EmbeddedSystemClass/LimeNET-Micro/hardware/2v1/LimeNet-Micro_2v1-SDR1/02.pdf

# Power diagram

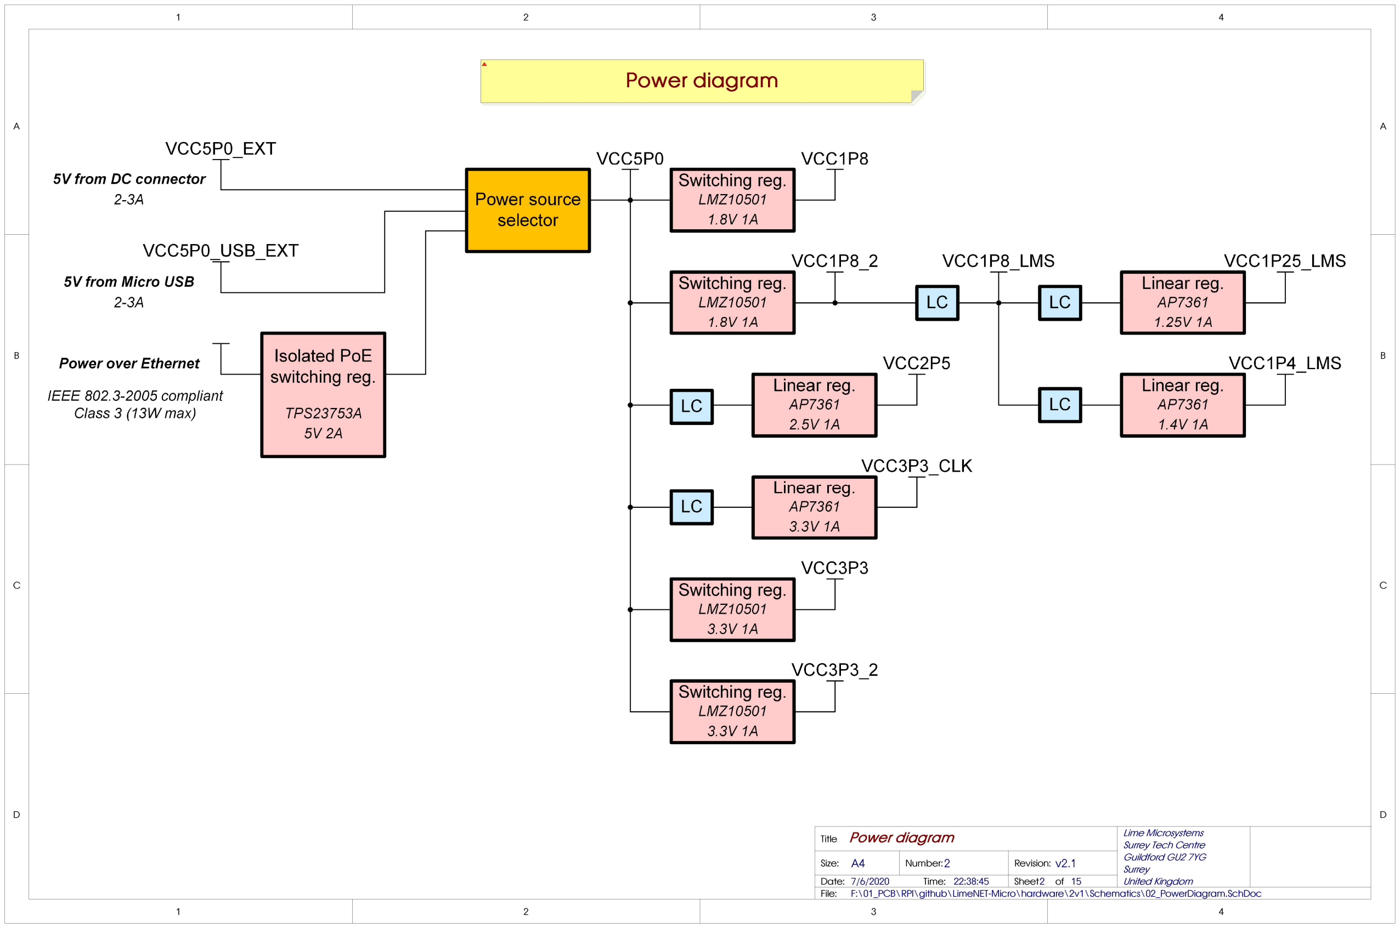
[picture p1: page 1]

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
Lime Microsystems
Surrey Tech Centre
Guildford GU2 7YG
Surrey

### 15 United Kingdom

## Power diagram

### 2 v2.1

7/6/2020 | 22:38:45
F:\01_PCB\RPI\github\LimeNET-Micro\hardware\2v1\Schematics\02_PowerDiagram.SchDoc

Title

Size: | Number:
Date:
File:

Revision:
Time: | Sheet | of

A4
