EmbeddedSystemClass/LimeNET-Micro/hardware/2v1/Project Outputs for LimeNet-Micro_2v1-SDR/BOM/LimeNET-Micro_2v1_SDR_BOMr2.xls

Item # | Comment | Quantity | Designator | Footprint | Manufacturer | Manufacturer Part Number 1 | Supplier 1 | Supplier Part Number 1 | Part Description | Assembly Info
1 | TCMT1107CT | 1 | AT1 | TCMT1107CT_optoisolator | Vishay Semiconductors | TCMT1107 | Digi-Key | TCMT1107CT-ND | Optoisolator Transistor Output 5000Vrms 1 Channel 4-SMD
2 | HD01-T | 2 | BR1, BR2 | HD01-T _RECTIFIER_BRIDGE_v1 | Diodes | HD01-T | Digi-Key | HD01DITR-ND | Bridge Rectifier Single Phase Standard 100V Surface Mount 4-MiniDIP
3 | 10pF, 25V | 8 | C1, C20, C21, C30, C31, C167, C168, C283 | CAP0402 | AVX | 04023A100JAT2A | Farnell | 2332478RL | 10pF ±5% 25V C0G, NP0 Ceramic Capacitor -55°C ~ 125°C Surface Mount, MLCC 0402 (1005 Metric) 0.039" L x 0.020" W (1.00mm x 0.50mm)
4 | 100nF, 16V | 73 | C2, C4, C6, C14, C17, C98, C135, C137, C138, C139, C141, C142, C143, C144, C145, C146, C147, C148, C149, C151, C153, C155, C156, C157, C158, C159, C160, C161, C162, C163, C164, C165, C166, C169, C177, C178, C179, C181, C202, C212, C214, C215, C217, C218, C219, C220, C221, C222, C223, C226, C227, C230, C233, C234, C235, C236, C237, C240, C244, C249, C252, C255, C258, C260, C261, C267, C272, C273, C282, C284, C330, MN15, MN20 | CAP0402 | Murata Electronics | GRM155R71C104KA88D | Mouser | 81-GRM155R71C104KA88 | CAP CER 0.1UF 16V X7R 0402 | NF(C135 C169 C179 C218 C220 C221 C222 C223 C255 C258 C272 C284)
5 | 100pF, 50V | 47 | C3, C5, C7, C8, C9, C10, C11, C12, C13, C15, C16, C18, C19, C22, C23, C24, C25, C26, C27, C28, C29, C32, C33, C34, C35, C36, C37, C38, C134, C136, C140, C239, C245, C246, C250, C251, C253, C254, C262, C263, C264, C265, C268, C269, C270, C271, C300 | CAP0402 | Yageo | CC0402JRNPO9BN101 | Digi-Key | 311-1024-1-ND | 100pF ±5% 50V C0G, NP0 Ceramic Capacitor -55°C ~ 125°C Surface Mount, MLCC 0402 (1005 Metric) 0.039" L x 0.020" W (1.00mm x 0.50mm) | NF(C7 C8 C18 C19 C24 C32)
6 | 1uF, 6.3V | 60 | C39, C42, C44, C46, C48, C50, C51, C52, C53, C54, C55, C56, C57, C58, C59, C60, C61, C62, C63, C65, C66, C67, C68, C69, C70, C72, C74, C76, C77, C78, C79, C80, C81, C82, C83, C84, C85, C86, C87, C88, C89, C90, C91, C92, C93, C94, C95, C96, C97, C100, C107, C114, C120, C124, C184, C186, C188, C190, C193, C201 | CAP0201 | TDK Corporation | JMK063ABJ105MP-F | Digi-Key | 587-5864-2-ND | 1µF ±20% 6.3V X5R Ceramic Capacitor -55°C ~ 85°C Surface Mount, MLCC 0201 (0603 Metric) 0.024" L x 0.012" W (0.60mm x 0.30mm)
7 | 10uF, 6.3V | 12 | C40, C99, C106, C113, C119, C123, C133, C183, C192, C200, C213, C325 | CAP0603 | Yageo | CC0603MRX5R5BB106 | Digi-Key | 311-1448-2-ND | 10µF ±20% 6.3V X5R Ceramic Capacitor -55°C ~ 85°C Surface Mount, MLCC 0603 (1608 Metric) 0.063" L x 0.031" W (1.60mm x 0.80mm)
8 | 1nF, 10% | 9 | C41, C43, C45, C47, C49, C64, C71, C73, C75 | CAP0201 | TDK Corporation | C0603X7R1E102K030BA | Digi-Key | 445-7275-1-ND | 1000pF ±10% 25V X7R Ceramic Capacitor -55°C ~ 125°C Surface Mount, MLCC 0201 (0603 Metric) 0.024" L x 0.012" W (0.60mm x 0.30mm)
9 | 100nF, 6.3V | 30 | C101, C102, C103, C104, C105, C108, C109, C110, C111, C112, C115, C116, C117, C118, C121, C122, C125, C126, C127, C128, C129, C130, C131, C185, C187, C189, C191, C194, C196, C198 | CAP0201 | Murata | GRT033C81A104KE01D | Digi-Key | 490-12232-1-ND | 0.10µF ±10% 6.3V X6S Ceramic Capacitor -55°C ~ 105°C Surface Mount, MLCC 0201 (0603 Metric) 0.024" L x 0.012" W (0.60mm x 0.30mm)
10 | 1uF, 10V | 17 | C132, C154, C204, C205, C206, C207, C229, C243, C247, C248, C256, C257, C266, C281, C292, C305, C329 | CAP0402 | Yageo | CC0402MRX5R6BB105 | Digi-Key | 311-1732-1-ND | 1µF 10V Ceramic Capacitor X5R 0402 (1005 Metric) 0.039" L x 0.020" W (1.00mm x 0.50mm) | NF(C256 C257)
11 | 4.7uF, 6.3V | 11 | C150, C203, C211, C312, C313, C314, C315, C318, C319, C320, C321 | CAP0402 | Murata Electronics North America | GRM155R60J475ME87D | Digi-Key | 490-5408-1-ND | 4.7µF ±20% 6.3V X5R Ceramic Capacitor -55°C ~ 85°C Surface Mount, MLCC 0402 (1005 Metric) 0.039" L x 0.020" W (1.00mm x 0.50mm) | NF(C312 C313)
12 | 22nF, 50V | 1 | C152 | CAP0402 | Kemet | C0402C223K5RACTU | Digi-Key | 399-7780-1-ND | 0.022µF ±10% 50V Ceramic Capacitor X7R 0402 (1005 Metric)
13 | 13pF, 5% | 4 | C170, C171, C172, C173 | CAP0402 | Murata Electronics North America | GRM1555C1H130JA01D | Digi-Key | 490-5925-2-ND | 13pF ±5% 50V C0G, NP0 Ceramic Capacitor -55°C ~ 125°C Surface Mount, MLCC 0402 (1005 Metric) 0.039" L x 0.020" W (1.00mm x 0.50mm)
14 | 47uF, 10V | 6 | C174, C208, C209, C210, C225, C228 | CAP1206 | TDK Corporation | C3216X6S1A476M160AC | Digi-Key | 445-6010-1-ND | 47µF ±20% 10V Ceramic Capacitor X6S 1206 (3216 Metric)
15 | 22uF, 10V | 13 | C175, C176, C224, C231, C232, C308, C309, C310, C311, C322, C323, C324, C326 | CAP0603 | TDK Corporation | C1608X5R1A226M080AC | Mouser | 810-C1608X5R1A226M | 22µF ±20% 10V X5R Ceramic Capacitor -55°C ~ 85°C Surface Mount, MLCC 0603 (1608 Metric) 0.063" L x 0.031" W (1.60mm x 0.80mm) | NF(C224)
16 | 10pF, 5% | 2 | C180, C182 | CAP0402 | AVX | 04023A100JAT2A | Farnell | 2332478RL | 10pF ±5% 25V C0G, NP0 Ceramic Capacitor -55°C ~ 125°C Surface Mount, MLCC 0402 (1005 Metric) 0.039" L x 0.020" W (1.00mm x 0.50mm)
17 | 10nF, 50V | 3 | C195, C197, C199 | CAP0402 | Murata Electronics North America | GRM155R71H103KA88D | Digi-Key | 490-4516-2-ND | 10000pF ±10% 50V Ceramic Capacitor X7R 0402 (1005 Metric)
18 | 4.7nF, 50V | 1 | C216 | CAP0402 | Murata Electronics North America | GCM155R71H472KA37D | Digi-Key | 490-4915-1-ND | 4700pF ±10% 50V Ceramic Capacitor X7R 0402 (1005 Metric)
19 | 10uF, 16V | 1 | C238 | CAP0603 | Yageo | GRM188R61C106MA73D | Digi-Key | 490-7201-2-ND | 10µF ±20% 16V Ceramic Capacitor X5R 0603 (1608 Metric)
20 | 47pF, 50V | 2 | C241, C242 | CAP0402 | TDK Corporation | C1005C0G1H470F050BA | Digi-Key | 445-5361-1-ND | 47pF ±1% 50V C0G, NP0 Ceramic Capacitor -55°C ~ 125°C Surface Mount, MLCC 0402 (1005 Metric) 0.039" L x 0.020" W (1.00mm x 0.50mm) | NF(C241 C242)
21 | 18nF, 16V | 1 | C259 | CAP0402 | Yageo | CC0402KRX7R7BB183 | Digi-Key | 311-1706-1-ND | 0.018µF ±10% 16V Ceramic Capacitor X7R 0402 (1005 Metric) | NF(C259)
22 | 1nF, 10% | 2 | C274, C275 | CAP0402 | Murata Electronics | GCM155R71H102KA37D | Mouser | 81-GCM155R71H102KA7D | 1000pF ±10% 50V X7R Ceramic Capacitor -55°C ~ 125°C Surface Mount, MLCC 0402 (1005 Metric) 0.039" L x 0.020" W (1.00mm x 0.50mm)
23 | 1nF, 50V | 1 | C276 | CAP0402 | Murata Electronics North America | GCM155R71H102KA37D | Digi-Key | 490-4761-1-ND | 1000pF ±10% 50V Ceramic Capacitor X7R 0402 (1005 Metric)
24 | 22pF, 5% | 3 | C277, C278, C279 | CAP0402 | Yageo | CC0402JRNPO9BN220 | Digi-Key | 311-1018-2-ND | 22pF ±5% 50V C0G, NP0 Ceramic Capacitor -55°C ~ 125°C Surface Mount, MLCC 0402 (1005 Metric) 0.039" L x 0.020" W (1.00mm x 0.50mm)
25 | 220pF, 10% | 1 | C280 | CAP0402 | Yageo | CC0402KRX7R9BB221 | Digi-Key | 311-1035-2-ND | 220pF ±10% 50V X7R Ceramic Capacitor -55°C ~ 125°C Surface Mount, MLCC 0402 (1005 Metric) 0.039" L x 0.020" W (1.00mm x 0.50mm)
26 | 100nF, 100V | 4 | C285, C293, C298, C299 | CAP0603 | Murata Electronics North America | GRM188R72A104KA35D | Digi-Key | 490-3285-1-ND | 0.1µF ±10% 100V Ceramic Capacitor X7R 0603 (1608 Metric)
27 | 10uF, 100V | 2 | C286, C287 | CAP_POL_SIZE_E | Panasonic | EEE2AA100UP | Digi-Key | PCE3966CT-ND | 10µF 100V Aluminum Electrolytic Capacitors Radial, Can - SMD 2000 Hrs @ 85°C
28 | 2.2uF, 100V | 2 | C288, C289 | CAP1206 | TDK Corporation | C3216X7S2A225K160AE | Digi-Key | 445-8900-1-ND | 2.2µF ±10% 100V Ceramic Capacitor X7S 1206 (3216 Metric)
29 | 1nF, 100V | 3 | C290, C291, C297 | CAP0603 | KEMET | C0603C102K1RACTU | Digi-Key | 399-7831-2-ND | 1000pF ±10% 100V Ceramic Capacitor X7R 0603 (1608 Metric)
30 | 100uF, 6.3V | 3 | C294, C295, C296 | CAP1210 | Murata | GRM32EC70J107ME15L | Digi-Key | 490-10530-1-ND | 100µF ±20% 6.3V Ceramic Capacitor X7S 1210 (3225 Metric)
31 | 1uF, 25V | 1 | C301 | CAP0603 | Samsung Electro-Mechanics | CL10A105KA8NNNC | Digi-Key | 1276-1102-1-ND | 1µF ±10% 25V Ceramic Capacitor X5R 0603 (1608 Metric)
32 | 22uF, 16V | 1 | C302 | CAP_POL_SIZE_B | Panasonic | EEE-FK1C220UR | Digi-Key | PCE3786CT-ND | 22µF 16V Aluminum Electrolytic Capacitors Radial, Can - SMD 2000 Hrs @ 105°C
33 | 6800pF, 50V | 1 | C303 | CAP0402 | Walsin Technologies | 0402B682K500CT | Digi-Key | 1292-1225-1-ND | 6800pF ±10% 50V Ceramic Capacitor X7R 0402 (1005 Metric)
34 | 47nF, 50V | 1 | C304 | CAP0603 | Yageo | CC0603KRX7R9BB473 | Digi-Key | 311-1427-1-ND | 0.047µF ±10% 50V Ceramic Capacitor X7R 0603 (1608 Metric)
35 | 1000pF, 2kV | 1 | C306 | CAP1812 | KEMET | C1812C102KGRACTU | Digi-Key | 399-3447-1-ND | 1000pF ±10% 2000V (2kV) Ceramic Capacitor X7R 1812 (4532 Metric)
36 | 470pF, 50V | 5 | C307, C316, C317, C327, C328 | CAP0402 | TDK Corporation | C1005C0G1H471J050BA | Digi-Key | 445-2656-6-ND | 470pF ±5% 50V Ceramic Capacitor C0G, NP0 0402 (1005 Metric) | NF(C307)
37 | MBR0530 | 1 | D1 | MBR0530T1G_shottky_diode_SOD123 | ON Semiconductor / Fairchild | MBR0530T1G | Digi-Key | MBR0530T1GOSCT-ND | Diode Schottky 30V 500mA Surface Mount SOD-123
38 | MMSZ5245B | 2 | D2, D3 | MMSZ5245B_shottky_diode_SOD123 | Vishay Semiconductors | MMSZ5245B-E3-18 | Digi-Key | MMSZ5245B-E3-18GICT-ND | Zener Diode 15V 500mW ±5% Surface Mount SOD-123
39 | MURA120 | 1 | D4 | MURA120T3G_diode_DO-214AC | ON Semiconductor | MURA120T3G | Digi-Key | MURA120T3GOSCT-ND | Diode Standard 200V 2A Surface Mount SMA
40 | MMSD4148T1G | 1 | D5 | MMSD4148T1G_diode_SOD123 | ON Semiconductor | MMSD4148-T1G | Digi-Key | MMSD4148T1GOSCT-ND | Diode Standard 100V 200mA (DC) Surface Mount SOD-123
41 | BAT54SLT1G | 1 | D6 | BAT54SLT1G_SOT23-3 | ON Semiconductor | BAT54SLT1G | Digi-Key | BAT54SLT1GOSCT-ND | Diode Array 1 Pair Series Connection Schottky 30V 200mA (DC) Surface Mount TO-236-3, SC-59, SOT-23-3
42 | TLV431 | 1 | D7 | SOT23-5 | Texas Instruments | TLV431AIDBVR | Digi-Key | 296-1984-1-ND | Shunt Voltage Reference IC 6V ±1% 15mA SOT-23-5
43 | ESD8472 | 4 | ESD1, ESD2, ESD3, ESD4 | ESD8472_X3DFN2 | ON Semiconductor | ESD8472MUT5G | Digi-Key | ESD8472MUT5GOSCT-ND | TVS DIODE 5.3VWM 14VC X3DFN2 | NF(ESD1 ESD2 ESD3 ESD4)
44 | Fiducial | 8 | F1, F2, F3, F4, F5, F6, F7, F8 | Fiducial
45 | Fiducial | 3 | FL1, FL2, FL3 | Fiducial_local
46 | 600R, 2A | 19 | FR1, FR36, FR37, FR38, FR40, FR41, FR42, FR43, FR44, FR45, FR47, FR48, FR49, FR50, FR51, FR52, FR53, FR54, FR55 | RES0805 | TDK Corporation | MPZ2012S601AT000 | Digi-Key | 445-2206-2-ND | FERRITE BEAD 600 OHM 0805 1LN | NF(FR50)
47 | 600R, 0.27A | 34 | FR2, FR3, FR4, FR5, FR6, FR7, FR8, FR9, FR10, FR11, FR12, FR13, FR14, FR15, FR16, FR17, FR18, FR19, FR20, FR21, FR22, FR23, FR24, FR25, FR26, FR27, FR28, FR29, FR30, FR31, FR32, FR33, FR34, FR46 | RES0201 | Taiyo Yuden | BK0603TS601-T | Digi-Key | 587-3277-1-ND | FERRITE BEAD 600 OHM 0201 1LN
48 | 220R, 0.9A | 2 | FR35, FR39 | RES0402 | TDK Corporation | MPZ1005S221ET000 | Digi-Key | 445-9329-2-ND | FERRITE BEAD 220 OHM 0402 1LN
49 | LMS7002M | 1 | IC1 | LMS7002M_v5 | Lime Microsystems | LMS7002M | Lime Microsystems | LMS7002M | IC FPRF Transceiver LMS7002M; 261 pin aQFN
50 | M24128 | 2 | IC2, IC16 | M24128-DFMC6TG | STMicroelectronics | M24128-DFMC6TG | Digi-Key | 497-15739-1-ND | EEPROM Memory IC 128Kb (16K x 8) I²C 1MHz 450ns 8-UFDFPN (2x3) | NF(IC2 IC16)
51 | CAT24C128WI-GT3 | 2 | IC3, IC18 | SOIC127P600-8DL_v2 | ON Semiconductor | CAT24C128WI-GT3 | Digi-Key | CAT24C128WI-GT3CT-ND | EEPROM Memory IC 128Kb (16K x 8) I²C 1MHz 400ns 8-SOIC
52 | PE42422 | 4 | IC4, IC8, IC10, IC11 | PE42422_QFN12 | Peregrine Semiconductor | PE42422MLAA-Z | Digi-Key | 1046-1062-1-ND | IC RF SWITCH SPDT 50 OHM 12QFN
53 | Duplexer B8 (B5) | 1 | IC5 | SAW_filter_duplexer_TAIYO_YUDEN_1p8x1p4_2p0x1p6 | Taiyo Yuden | D5DA942M5K2S2 | Taiyo Yuden | D5DA942M5K2S2 | RF Diplexor 880MHz ~ 915MHz / 925MHz ~ 960MHz 8-SMD, No Lead | NF(IC5)
54 | SKY13411-374LF | 2 | IC6, IC9 | SKY13411-374LF | Skyworks Solutions Inc. | SKY13411-374LF | Digi-Key | 863-1455-1-ND | RF Switch IC 802.11a/b/g/n DPDT 50 Ohm 6-MLPD (1.5x1.5)
55 | Duplexer B3 (B2) | 1 | IC7 | SAW_filter_duplexer_TAIYO_YUDEN_1p8x1p4_2p0x1p6 | Taiyo Yuden | D6DA1G842K2C4-Z | Taiyo Yuden | D6DA1G842K2C4-Z | SAW DUPLEXER, LTE, BAND 3, 1814 | NF(IC7)
56 | 10M16SAU169C8G | 1 | IC12 | 10M16SAU169C8G | Altera | 10M16SAU169C8G | Digi-Key | 544-3110-ND | IC FPGA/CPLD NV 130 I/O 169UBGA
57 | LM75 | 1 | IC13 | HWSON8_LM75 | NXP Semiconductors | LM75BTP,147 | Digi-Key | 568-9815-2-ND | SENSOR TEMPERATURE I2C 8HWSON
58 | NEO-M8Q | 1 | IC14 | NEO-7M/8M | u-blox | Loading... | Digi-Key | 672-1009-1-ND
59 | 74AHC595 | 4 | IC15, IC17, IC19, IC22 | 74HC595BQ,115 | Nexperia USA Inc. | 74AHC595BQ,115 | Digi-Key | 1727-6021-2-ND | C 8BIT SHIFT REGISTER 16-DHVQFN
60 | ATECC508A | 1 | IC20 | ATECC508A_UDFN8 | Microchip | ATECC508A-MAHDA-S | Digi-Key | ATECC508A-MAHDA-SDKR-ND | Authentication Chip IC Networking and Communications 8-UDFN (2x3)
61 | ATECC508A | 1 | IC21 | SOIC127P600-8DL_v2 | Microchip Technology | ATECC508A-SSHDA-T | Digi-Key | ATECC508A-SSHDA-TCT-ND | Authentication Chip IC Networking and Communications 8-SOIC | NF(IC21)
62 | IS25LQ040 | 1 | IC23 | M25P40-VMN6TPB_SO8N | ISSI, Integrated Silicon Solution Inc | IS25LQ040B-JNLE | Digi-Key | 706-1316-ND | FLASH - NOR Memory IC 4Mb (512K x 8) SPI - Quad I/O 104MHz 8-SOIC
63 | LAN9514-JZX | 1 | IC24 | LAN9514I-JZX_QFN50P900X900X100-65N | Microchip Technology | LAN9514-JZX-TR | Digi-Key | LAN9514-JZX-DKR-ND | Ethernet Bridge, USB to Ethernet USB 2.0, 10/100 Base-T/TX PHY USB Interface 64-QFN (9x9
64 | 93LC66AT | 1 | IC25 | SOIC127P600-8DL_v2 | Microchip Technology | 93LC66AT-I/SN | Digi-Key | 93LC66AT-I/SNDKR-ND | EEPROM Memory IC 4Kb (512 x 8) SPI 2MHz 8-SOIC | NF(IC25)
65 | AP2553 | 2 | IC26, IC33 | SOT23-6 | Diodes | AP2553W6-7 | Digi-Key | AP2553W6-7DIDKR-ND | IC PD SW CURR LIMIT SOT26
66 | FT601Q | 1 | IC27 | FT601Q | FTDI, Future Technology Devices International Ltd | FT601Q-B-T | Digi-Key | 768-1311-ND | IC USB3-32BIT SYNC FIFO 76QFN
67 | FSUSB42UMX | 3 | IC28, IC29, IC31 | FSUSB42UMX | ON Semiconductor | FSUSB42UMX | Digi-Key | FSUSB42UMXCT-ND | USB Switch IC 1 Channel 10-UMLP (1.8x1.4)
68 | WiFi Module WF111 | 1 | IC30 | WF111-A-V1_WIFI | Bluegiga Technologies | WF111-A-V1 | Digi-Key | 1446-1031-6-ND | RF TXRX MODULE WIFI CHIP ANT | NF(IC30)
69 | NC7WZ16P6X | 1 | IC32 | SC-70_NC7WZ16P6X | ON Semiconductor / Fairchild | NC7WZ16P6X | Digi-Key | NC7WZ16P6XDKR-ND | Buffer, Non-Inverting 2 Element 1 Bit per Element Push-Pull Output SC-70-6
70 | LMK00105 | 1 | IC34 | LMK00105SQ | Texas Instruments | LMK00105SQ/NOPB | Digi-Key | LMK00105SQ/NOPBCT-ND | IC CLK BUFFER 2:5 200MHZ 24WQFN
71 | AD5662 | 1 | IC35 | AD5662_SOT23-8 | Analog Devices Inc. | AD5662BRJZ-2REEL7 | Digi-Key | AD5662BRJZ-2REEL7CT-ND | IC DAC 16BIT BUFF V-OUT SOT23-8
72 | ADF4002 | 1 | IC36 | ADF4002 | Analog Devices Inc | ADF4002BCPZ-RL7 | Digi-Key | ADF4002BCPZ-RL7CT-ND | IC PLL FREQUENCY SYNTH 20-LFCSP
73 | AD5601BKSZ-REEL7 | 1 | IC37 | AD5601_SOT23-6 | Analog Devices | AD5601BKSZ-REEL7 | Digi-Key | AD5601BKSZ-REEL7TR-ND | IC DAC 8BIT BUFF V-OUT SC70-6 | NF(IC37)
74 | TPS23753APWR | 1 | IC38 | TPS23753APWR _TSSOP14 | Texas Instruments | TPS23753APWR | Digi-Key | 296-39365-1-ND | Power Over Ethernet Controller 1 Channel 802.3at (PoE+), 802.3af (PoE) 14-TSSOP
75 | LMZ10501 | 4 | IC39, IC40, IC45, IC46 | LMZ10501 | Texas Instruments | LMZ10501SILR | Digi-Key | 296-37104-1-ND | n Non-Isolated PoL Module DC DC Converter 1 Output 0.6 ~ 3.6 V 1A 2.7V - 5.5V Input
76 | AP7361-FGE | 4 | IC41, IC42, IC43, IC44 | AP7361 | Diodes Incorporated | AP7361-FGE-7 | Digi-Key | AP7361-FGE-7DICT-ND | IC REG LDO ADJ 1A 8DFN | NF(IC41)
77 | SMA board edge | 6 | J1, J2, J7, J20, J24, J25 | SMA_connector_board_edge_SM | RF Solutions | CON-SMA-EDGE-S | Digi-Key | CON-SMA-EDGE-S-ND | SMA Connector Jack, Female Socket Board Edge, End Launch Solder | NF(J20)
78 | FPGA JTAG (board edge) | 1 | J3 | Header7x1_TH | Sullins Connector Solutions | PEC07SAAN | Digi-Key | S1012E-07-ND | 7 Positions Header, Unshrouded, Breakaway Connector 0.100" (2.54mm) Through Hole Tin | NF(J3)
79 | FPGA JTAG | 1 | J4 | SWD_10_pin | Harwin Inc | M50-3600542 | Digi-Key | 952-1389-ND | CONN HDR 1.27MM SMD AU 10POS
80 | FPGA GPIO | 1 | J5 | SWD_10_pin | Harwin Inc | M50-3600542 | Digi-Key | 952-1389-ND | CONN HDR 1.27MM SMD AU 10POS
81 | Batt | 1 | J6 | HDR_1x2 | 3M | 961102-6404-AR | Digi-Key | 3M9447-ND | 2 Positions Header, Unshrouded Connector 0.100" (2.54mm) Through Hole Gold | NF(J6)
82 | FAN | 1 | J8 | HDR_1x2 | 3M | 961102-6404-AR | Digi-Key | 3M9447-ND | 2 Positions Header, Unshrouded Connector 0.100" (2.54mm) Through Hole Gold
83 | SI-52003-F | 1 | J9 | RJ45_SI-52003-F | Stewart Connector | SI-52003-F | Digi-Key | 380-1119-ND | 1 Port RJ45 Magjack Connector Through Hole 10/100 Base-T, AutoMDIX, Power over Ethernet (PoE)
84 | 2xUSB A | 1 | J10 | USB_typeA_double_USBR-A-D-F-O-TH | Samtec | USBR-A-D-F-O-TH | Digi-Key | SAM10376-ND | USB - A USB 2.0 Receptacle Connector 8 Position Through Hole, Right Angle
85 | USB | 2 | J11, J12 | HEADER4X1_TH | Wurth Electronics Inc. | 61300411121 | Digi-Key | 732-5317-ND | 4 Positions Header Connector 0.100" (2.54mm) Through Hole Gold | NF(J11 J12)
86 | DDR2 (1.8V) SODIMM SOCKET | 1 | J13 | TE_1717254-1_DDR_SODIMM | TE Connectivity AMP Connectors | 1717254-4 | Digi-Key | A130932CT-ND | 200 Position SODIMM DDR SDRAM Socket Surface Mount, Right Angle
87 | USB Boot | 1 | J14 | HDR_1x2 | 3M | 961102-6404-AR | Digi-Key | 3M9447-ND | 2 Positions Header, Unshrouded Connector 0.100" (2.54mm) Through Hole Gold
88 | USB Micro Type B | 1 | J15 | microUSB_v2 | Amphenol FCI | 10118193-0001LF | Digi-Key | 609-4616-2-ND | CONN USB MICRO B RECPT SMT R/A
89 | Micro SD card holder | 1 | J16 | MICRO_SD_CARD_114-00841-68_v2 | Amphenol Commercial Products | 114-00841-68 | Digi-Key | 114-00841-68-1-ND | 10 (8 + 2) Position Card Connector Secure Digital - microSD™ Surface Mount, Right Angle Gold
90 | UART | 1 | J17 | HEADER4X1_TH | Wurth Electronics Inc. | 61300411121 | Digi-Key | 732-5317-ND | 4 Positions Header Connector 0.100" (2.54mm) Through Hole Gold
91 | EXT_USB | 1 | J18 | HDR_1x2 | 3M | 961102-6404-AR | Digi-Key | 3M9447-ND | 2 Positions Header, Unshrouded Connector 0.100" (2.54mm) Through Hole Gold
92 | HDMI | 1 | J19 | HDMI_AMPHENOL_10029449-111RLF | Amphenol FCI | 10029449-111RLF | Mouser | 649-10029449-111RLF | HDMI HDMI™ 1.4 Receptacle Connector 19 Position Surface Mount, Right Angle; Through Hole
93 | A/V, 3.5mm | 1 | J21 | Audio_jack_3.5mm | CUI Inc. | SJ-43515TS | Digi-Key | CP-43515TS-ND | CONN JACK 4COND 3.5MM R/A
94 | FPC 15-pin | 2 | J22, J23 | FPC_CONNECTOR_15pin_1-1734248-5 | TE Connectivity | 1-1734248-5 | Digi-Key | A101418DKR-ND | 15 Position FPC Connector Contacts, Vertical, 1 Sided 0.039" (1.00mm) Surface Mount
95 |  | 1 | J26 | HDR_1x2 | 3M | 961102-6404-AR | Digi-Key | 3M9447-ND | 2 Positions Header, Unshrouded Connector 0.100" (2.54mm) Through Hole Gold
96 | Header 3X2 | 1 | J27 | Header3x2 | Harwin | M20-9980346 | Digi-Key | 952-2121-ND | Connector Header Through Hole 6 position 0.100" (2.54mm)
97 | CONN_PWR_JACK_2.1x5.5mm | 1 | J28 | CONN_PWR_JACK_v2 | CUI | PJ-002A | Digi-Key | CP-002A-ND | Power Barrel Connector Jack 2.10mm ID (0.083"), 5.50mm OD (0.217") Through Hole, Right Angle
98 | 1 pcs. | 3 | JMP1, JMP2, JMP3 |  | Sullins | SPC02SYAN | Digi-Key | S9001-ND | 2 (1 x 2) Position Shunt Connector Black Closed Top 0.100" (2.54mm) Gold | NF(JMP2)
99 | 47nH | 1 | L1 | RES0402 | COILCRAFT | 0402HP-47NXJLU | Farnell | 2285856 | COILCRAFT 0402HP-47NXJLU Surface Mount High Frequency Inductor, 0402HP Series, 47 nH, 420 mA, 0402 [1005 Metric], Wirewound
100 | 10uH, 1.2A | 1 | L2 | NRS4018T3R3MDGJ_inductor | Taiyo Yuden | NRS4018T100MDGJ | Digi-Key | 587-2886-1-ND | FIXED IND 10UH 1.2A 180 MOHM SMD
101 | 3.3uH, 2.2A | 1 | L3 | NRS4018T3R3MDGJ_inductor | Bourns | SRN4018-3R3M | Digi-Key | SRN4018-3R3MCT-ND | 3.3µH Semi-Shielded Wirewound Inductor 2.2A 66 mOhm Max Nonstandard
102 | LED_RG_SMD | 6 | LED1, LED2, LED3, LED4, LED5, LED6 | LED-2x0603 | Avago Technologies US Inc. | HSMF-C165 | Digi-Key | 516-1419-1-ND | LED GREEN/RED DIFFUSED 0603 SMD
103 | WST-1203UX | 1 | LS1 | BUZZER_WST-1203UX | Soberton Inc. | WST-1203UX | Digi-Key | 433-1047-ND | Buzzers Indicator, Internally Driven Magnetic 3V 30mA 2.3kHz 82dB @ 3V, 10cm Through Hole PC Pins
104 | BMI-S-230-C | 2 | MECH1, MECH3 |  | Laird Technologies EMI | BMI-S-230-C | Digi-Key | 903-1471-ND | RF Shield Cover 2.000" (50.80mm) X 1.500" (38.10mm) Vent Holes in Pattern Snap Fit
105 | BMI-S-230-F-R | 2 | MECH2, MECH4 | RFI_SHIELD_BMI-S-230-F-R | Laird Technologies EMI | BMI-S-230-F-R | Digi-Key | 903-1470-1-ND | RF Shield Frame 2.000" (50.80mm) X 1.500" (38.10mm) Solder
106 | # pcs. | 4 | MECH5, MECH6, MECH7, MECH8 | PCB_standoff | FIX&FASTEN | FIX-MAE-5TV | TME | FIX-MAE-5TV | PCB distance; polyamide; L:5mm; Colour: natural; Øcutout:3mm
107 | 8.2nH, 5% | 5 | MN1, MN2, MN4, MN5, MN22 | RES0402 | COILCRAFT | 0402HP-8N2XJLU | Farnell | 2285826 | Surface Mount High Frequency Inductor, 0402HP Series, 8.2 nH, ± 5%, 0402 [1005 Metric], 5.4 GHz | NF(MN4 MN5 MN22)
108 | 0.8pF | 2 | MN3, MN9 | CAP0402 | Murata Electronics North America | GRM1555C1HR80BA01D | Digi-Key | 490-6269-1-ND | 0.80pF ±0.1pF 50V C0G, NP0 Ceramic Capacitor -55°C ~ 125°C Surface Mount, MLCC 0402 (1005 Metric) 0.039" L x 0.020" W (1.00mm x 0.50mm)
109 | 1pF | 3 | MN6, MN18, MN27 | CAP0402 | TDK Corporation | C1005C0G1H010B050BA | Digi-Key | 445-4854-6-ND | 1pF ±0.1pF 50V C0G, NP0 Ceramic Capacitor -55°C ~ 125°C Surface Mount, MLCC 0402 (1005 Metric) 0.039" L x 0.020" W (1.00mm x 0.50mm) | NF(MN6 MN18)
110 | 0.5pF | 2 | MN7, MN26 | CAP0402 | Yageo | CC0402CRNPO9BNR50 | Digi-Key | 311-1001-1-ND | 0.50pF ±0.25pF 50V C0G, NP0 Ceramic Capacitor -55°C ~ 125°C Surface Mount, MLCC 0402 (1005 Metric) 0.039" L x 0.020" W (1.00mm x 0.50mm) | NF(MN26)
111 | 22nH, 5% | 1 | MN8 | RES0402 | Murata Electronics North America | LQW15AN22NJ00D | Digi-Key | 490-1150-1-ND | 22nH Unshielded Wirewound Inductor 310mA 300 mOhm Max 0402 (1005 Metric) | NF(MN8)
112 | 100uH | 2 | MN10, MN11 | RES0805 | TDK Corporation | MLF2012C101KT000 | Digi-Key | 445-1071-1-ND | FIXED IND 100UH 2MA 3.1 OHM SMD
113 | 4.3nH, 5% | 1 | MN12 | RES0402 | TDK Corporation | MLG1005S4N3STD25 | Digi-Key | 445-16307-1-ND | 4.3nH Unshielded Multilayer Inductor 700mA 200 mOhm Max 0402 (1005 Metric) | NF(MN12)
114 | 0R | 65 | MN13, MN14, R15, R16, R17, R18, R19, R22, R23, R32, R33, R34, R35, R36, R37, R44, R46, R47, R49, R52, R53, R54, R55, R56, R57, R59, R61, R63, R71, R80, R92, R95, R96, R97, R102, R109, R114, R121, R122, R123, R126, R128, R129, R130, R132, R134, R143, R148, R149, R161, R163, R164, R167, R170, R172, R173, R176, R180, R184, R203, R209, R229, R230, R238, R240 | RES0402 | Yageo | RC0402JR-070RL | Digi-Key | 311-0.0JRTR-ND | RES SMD 0.0OHM JUMPER 1/16W 0402 | NF(R22 R33 R34 R47 R49 R52 R53 R55 R57 R59 R63 R71 R92 R96 R97 R114 R121 R122 R126 R128 R129 R132 R143 R148 R149 R170 R172 R173 R240)
115 | 12nH, 5% | 1 | MN16 | RES0402 | Murata Electronics North America | LQG15HS12NJ02D | Digi-Key | 490-2624-1-ND | 12nH Unshielded Multilayer Inductor 500mA 280 mOhm Max 0402 (1005 Metric) | NF(MN16)
116 | 10nH, 5% | 1 | MN17 | RES0402 | Murata Electronics North America | LQG15HS10NJ02D | Digi-Key | 490-2623-1-ND | 10nH Unshielded Multilayer Inductor 500mA 260 mOhm Max 0402 (1005 Metric) | NF(MN17)
117 | 2pF | 3 | MN19, MN25, MN28 | CAP0402 | AVX | 04025U2R0BAT2A | Farnell | 2332536 | SMD Multilayer Ceramic Capacitor, U Series, 2 pF, ± 0.1pF, C0G / NP0, 50 V, 0402 [1005 Metric]
118 | 510pF | 2 | MN21, MN24 | CAP0402 | Murata Electronics North America | GRM1555C1H511JA01D | Digi-Key | 490-3237-1-ND | 510pF ±5% 50V C0G, NP0 Ceramic Capacitor -55°C ~ 125°C Surface Mount, MLCC 0402 (1005 Metric) 0.039" L x 0.020" W (1.00mm x 0.50mm)
119 | 1.2pF | 1 | MN23 | CAP0402 | Murata Electronics North America | GRM1555C1H1R2CA01D | Digi-Key | 490-5927-1-ND | '1.2pF ±0.25pF 50V C0G, NP0 Ceramic Capacitor -55°C ~ 125°C Surface Mount, MLCC 0402 (1005 Metric) 0.039" L x 0.020" W (1.00mm x 0.50mm)
120 | Raspberry Pi Compute Module 3+ (8GB eMMC) | 1 | PC1 |  | RASPBERRY-PI | CM3+/8GB | Farnell | 2989462 | Single Board Computer, Raspberry Pi Compute Module 3 +, BCM2837B0 SoC, 8GB eMMC Memory
121 | 10k, 1% | 38 | R1, R2, R3, R4, R5, R10, R11, R26, R27, R28, R29, R30, R38, R39, R40, R41, R42, R43, R51, R69, R75, R76, R78, R85, R88, R90, R91, R99, R104, R105, R106, R159, R187, R188, R189, R195, R207, R212 | RES0402 | Yageo | RC0402FR-0710KL | Digi-Key | 311-10.0KLRTR-ND | RES SMD 10K OHM 1% 1/16W 0402 | NF(R27 R104 R195)
122 | 49.9R, 1% | 18 | R6, R7, R8, R9, R79, R82, R83, R84, R144, R165, R177, R183, R191, R192, R193, R196, R197, R198 | RES0402 | Samsung Electro-Mechanics America, Inc. | RC1005F49R9CS | Digi-Key | 1276-3469-6-ND | RES SMD 49.9 OHM 1% 1/16W 0402 | NF(R144)
123 | 2k2, 1% | 4 | R12, R13, R154, R156 | RES0402 | Stackpole Electronics Inc | RMCF0402FT2K20 | Digi-Key | RMCF0402FT2K20CT-ND | RES SMD 2.2K OHM 1% 1/16W 0402
124 | 0R | 1 | R14 | RES0201 | Rohm Semiconductor | RC0201FR-070RL | Digi-Key | 311-0.0MCT-ND | RES SMD 0.0OHM JUMPER 1/20W 0201
125 | 10R | 4 | R20, R21, R24, R25 | RES0201 | Panasonic Electronic Components | ERJ-1GEF10R0C | Digi-Key | P10.0ABCT-ND | RES SMD 10 OHM 1% 1/20W 0201
126 | 1k, 1% | 12 | R31, R73, R113, R146, R147, R179, R181, R186, R217, R219, R224, R232 | RES0402 | Stackpole Electronics Inc | RMCF0402FT1K00 | Digi-Key | RMCF0402FT1K00TR-ND | RES SMD 1K OHM 1% 1/16W 0402 | NF(R146 R147 R186 R219)
127 | 3k, 1% | 6 | R45, R48, R127, R133, R185, R194 | RES0402 | Vishay Dale | CRCW04023K00FKED | Digi-Key | 541-3.00KLCT-ND | RES SMD 3K OHM 1% 1/16W 0402 | NF(R194)
128 | 10R, 5% | 3 | R50, R81, R178 | RES0402 | Yageo | RC0402JR-0710RL | Digi-Key | 311-10JRTR-ND | RES SMD 10 OHM 5% 1/16W 0402
129 | 100R, 1% | 14 | R58, R60, R62, R64, R65, R66, R67, R68, R70, R72, R87, R89, R153, R155 | RES0402 | Stackpole Electronics Inc. | RMCF0402FT100R | Digi-Key | RMCF0402FT100RDKR-ND | RES SMD 100 OHM 1% 1/16W 0402
130 | 249R, 1% | 3 | R74, R152, R157 | RES0402 | Stackpole Electronics Inc | RMCF0402FT249R | Digi-Key | RMCF0402FT249RCT-ND | RES SMD 249 OHM 1% 1/16W 0402
131 | 1M, 1% | 1 | R86 | RES0402 | Yageo | RC0402FR-071ML | Digi-Key | 311-1.00MLRCT-ND | 1 MOhms ±1% 0.063W, 1/16W Chip Resistor 0402 (1005 Metric) Moisture Resistant Thick Film
132 | 12k, 1% | 1 | R93 | RES0402 | Samsung Electro-Mechanics | RC1005F123CS | Digi-Key | 1276-4122-1-ND | 12 kOhms ±1% 0.063W, 1/16W Chip Resistor 0402 (1005 Metric) Moisture Resistant Thick Film
133 | 12.4k, 1% | 1 | R94 | RES0402 | Yageo | RT0402BRE0712K4L | Digi-Key | YAG4337CT-ND | 12.4 kOhms ±0.1% 0.063W, 1/16W Chip Resistor 0402 (1005 Metric) Thin Film
134 | 0R | 8 | R98, R158, R162, R166, R168, R169, R171, R174 | RES0402_v2 | Yageo | RC0402JR-070RL | Digi-Key | 311-0.0JRTR-ND | RES SMD 0.0OHM JUMPER 1/16W 0402 | NF(R98 R158 R166 R168 R169 R171 R174)
135 | 44.2k, 1% | 4 | R100, R101, R160, R208 | RES0402 | Panasonic Electronic Components | ERJ-2RKF4422X | Digi-Key | P44.2KLCT-ND | RES SMD 44.2K OHM 1% 1/10W 0402 | NF(R101)
136 | 4K7, 1% | 1 | R103 | RES0402 | Yageo | RC0402FR-074K7L | Digi-Key | 311-4.7KLRCT-ND | ±1% 0.063W, 1/16W Chip Resistor 0402 (1005 Metric) Moisture Resistant Thick Film | NF(R103)
137 | 1k6, 1% | 1 | R108 | RES0402 | Yageo | RC0402FR-071K6L | Digi-Key | YAG3045CT-ND | RES SMD 1.6K OHM 1% 1/16W 0402
138 | 100k, 1% | 10 | R110, R111, R115, R116, R124, R125, R131, R145, R150, R151 | RES0402 | Vishay Dale | ERJ-2GEJ104X | Digi-Key | 541-3960-1-ND | RES SMD 100K OHM 1% 1/10W 0402
139 | 22R | 10 | R77, R107, R112, R135, R136, R137, R139, R140, R142, R175 | RES0402 | Yageo | RC0402FR-0722RL | Digi-Key | 311-22.0LRTR-ND | RES SMD 22 OHM 1% 1/16W 0402 | NF(R175)
140 | 0R | 7 | R117, R118, R119, R120, R235, R239, R241 | RES0805 | Vishay Dale | CRCW08050000Z0EA | Digi-Key | 541-0.0ATR-ND | RES SMD 0.0 OHM JUMPER 1/8W 0805 | NF(R119 R235 R239 R241)
141 | 47.5k, 1% | 1 | R138 | RES0402 | Yageo | RC0402FR-0747K5L | Digi-Key | 311-47.5KLRCT-ND | RES SMD 47.5K OHM 1% 1/16W 0402
142 | 1M | 1 | R141 | RES0402 | TE CONNECTIVITY | CRG0402F1M0 | Farnell | 2331481 | RES SMD 1M OHM 1% 1/16W 0402
143 | 470R, 0.5% | 2 | R182, R223 | RES0402 | Panasonic Electronic Components | ERA-2AED471X | Digi-Key | P470DETR-ND | RES SMD 470 OHM 0.5% 1/16W 0402 | NF(R223)
144 | 330R, 5% | 1 | R190 | RES0402 | Yageo | RC0402JR-07330RL | Digi-Key | 311-330JRTR-ND | RES SMD 330 OHM 5% 1/16W 0402
145 | 10R, 1% | 2 | R199, R216 | RES0603 | Vishay | CRCW060310R0FKEAC | Digi-Key | 541-3952-1-ND | 10 Ohms ±1% 0.1W, 1/10W Chip Resistor 0603 (1608 Metric) Thick Film
146 | 39k, 1% | 1 | R200 | RES0805 | Yageo | RC0805FR-0739KL | Digi-Key | 311-39.0KCRCT-ND | 39 kOhms ±1% 0.125W, 1/8W Chip Resistor 0805 (2012 Metric) Moisture Resistant Thick Film
147 | 10R, 1% | 1 | R201 | RES0805 | Vishay | CRCW080510R0FKEAC | Digi-Key | 541-4132-1-ND | 10 Ohms ±1% 0.125W, 1/8W Chip Resistor 0805 (2012 Metric) Thick Film
148 | 24.9k, 1% | 1 | R202 | RES0402 | Yageo | RC0402FR-0724K9L | Digi-Key | 311-24.9KLRCT-ND | 24.9 kOhms ±1% 0.063W, 1/16W Chip Resistor 0402 (1005 Metric) Moisture Resistant Thick Film
149 | 90.9R. 1% | 1 | R204 | RES0603 | Yageo | RC0603FR-0790R9L | Digi-Key | 311-90.9HRCT-ND | 90.9 Ohms ±1% 0.1W, 1/10W Chip Resistor 0603 (1608 Metric) Moisture Resistant Thick Film
150 | 20R 1% | 1 | R205 | RES0805 | Yageo | RC0805FR-0720RL | Digi-Key | 311-20.0CRCT-ND | 20 Ohms ±1% 0.125W, 1/8W Chip Resistor 0805 (2012 Metric) Moisture Resistant Thick Film
151 | 680R, 1% | 2 | R206, R215 | RES0402 | Yageo | RC0402FR-07680RL | Digi-Key | 311-680LRCT-ND | 680 Ohms ±1% 0.063W, 1/16W Chip Resistor 0402 (1005 Metric) Moisture Resistant Thick Film
152 | 80.6k, 1% | 1 | R210 | RES0402 | Yageo | RC0402FR-0780K6L | Digi-Key | 311-80.6KLRCT-ND | 80.6 kOhms ±1% 0.063W, 1/16W Chip Resistor 0402 (1005 Metric) Moisture Resistant Thick Film
153 | 59k, 1% | 1 | R211 | RES0402 | Yageo | RC0402FR-0759KL | Digi-Key | 311-59KLRCT-ND | 59 kOhms ±1% 0.063W, 1/16W Chip Resistor 0402 (1005 Metric) Moisture Resistant Thick Film
154 | 2k, 1% | 1 | R213 | RES0402 | Yageo | RC0402FR-072KL | Digi-Key | 311-2KLRCT-ND | 2 kOhms ±1% 0.063W, 1/16W Chip Resistor 0402 (1005 Metric) Moisture Resistant Thick Film
155 | 14.3k, 1% | 1 | R214 | RES0402 | Yageo | RC0402FR-0714K3L | Digi-Key | YAG2983CT-ND | 14.3 kOhms ±1% 0.063W, 1/16W Chip Resistor 0402 (1005 Metric) Moisture Resistant Thick Film
156 | 0.5R, 1% | 1 | R218 | RES1206 | Yageo | RL1206FR-070R5L | Digi-Key | 311-0.5LWCT-ND | 500 mOhms ±1% 0.25W, 1/4W Chip Resistor 1206 (3216 Metric) Automotive AEC-Q200, Current Sense, Moisture Resistant Thick Film
157 | 560R, 1% | 1 | R220 | RES0402 | Vishay Dale | CRCW0402560RFKED | Digi-Key | 541-560LCT-ND | RES SMD 560 OHM 1% 1/16W 0402
158 | 118k, 1% | 2 | R221, R222 | RES0402 | Yageo | RC0402FR-07118KL | Digi-Key | YAG2369CT-ND | 118 kOhms ±1% 0.063W, 1/16W Chip Resistor 0402 (1005 Metric) Moisture Resistant Thick Film
159 | 150k, 1% | 2 | R225, R226 | RES0402 | Yageo | RC0402JR-07150KL | Digi-Key | 311-150KJRCT-ND | 150 kOhms ±5% 0.063W, 1/16W Chip Resistor 0402 (1005 Metric) Moisture Resistant Thick Film
160 | 1.6k, 1% | 1 | R227 | RES0402 | Yageo | RC0402FR-071K6L | Digi-Key | YAG3045CT-ND | 1.6 kOhms ±1% 0.063W, 1/16W Chip Resistor 0402 (1005 Metric) Moisture Resistant Thick Film
161 | 750R, 1% | 1 | R228 | RES0402 | Yageo | RC0402FR-07750RL | Digi-Key | 311-750LRCT-ND | RES SMD 750 OHM 1% 1/16W 0402
162 | 510R, 1% | 1 | R231 | RES0402 | Yageo | RC0402FR-07510RL | Digi-Key | 311-510LRCT-ND | 510 Ohms ±1% 0.063W, 1/16W Chip Resistor 0402 (1005 Metric) Moisture Resistant Thick Film
163 | 187k, 1% | 2 | R233, R234 | RES0402 | Yageo | RC0402FR-07187KL | Digi-Key | 311-187KLRCT-ND | 187 kOhms ±1% 0.063W, 1/16W Chip Resistor 0402 (1005 Metric) Moisture Resistant Thick Film
164 | 82.5k, 1% | 2 | R236, R237 | RES0402 | Yageo | RC0402FR-0782K5L | Digi-Key | 311-82.5KLRCT-ND | 82.5 kOhms ±1% 0.063W, 1/16W Chip Resistor 0402 (1005 Metric) Moisture Resistant Thick Film
165 | Switch tactile right edge | 1 | SB1 | SW_TACTILE_RIGHT_EDGE | TE Connectivity ALCOSWITCH Switches | 1825027-5 | Digi-Key | 450-1662-ND | Tactile Switch SPST-NO Side Actuated Through Hole, Right Angle
166 | TC1-1-13M-45+ | 4 | T1, T2, T3, T4 | TC1-1-13MA+_JA4220-AL_ | Minicircuits | TC1-1-13M-45+ | Minicircuits | TC1-1-13M-45+ | RF balun; 1:1 ratio; 3 dB bandwidth: 0.3 MHz to 3.5 GHz; 3.8mm x 3.8mm
167 | NA6223-AL | 1 | T5 | PoE13P-50L_Flyback_transformer | Coilcraft | NA6223-ALD | Mouser | 994-NA6223-ALD | Audio Transformers / Signal Transformers NA6223 10W 0.33Ohms For TPS23753A
168 | ESD5384 | 1 | VD1 | TVS_ESD5384NCTBG | ON Semiconductor | ESD5384NCTBG | Digi-Key | ESD5384NCTBGOSDKR-ND | TVS DIODE 3V 9WLCSP
169 | BAV99WT1G | 1 | VD2 | SC-70_BAV99WT1G | ON Semiconductor | SBAV99WT1G | Digi-Key | SBAV99WT1GOSCT-ND | Diode Array 1 Pair Series Connection Standard 100V 215mA (DC) Surface Mount SC-70, SOT-323
170 | SMAJ58A | 1 | VD3 | SMAJ58A_shottky_diode | Diodes Incorporated | SMAJ58A-13-F | Digi-Key | SMAJ58A-13-FDICT-ND | TVS DIODE 58V 93.6V SMA
171 | SMBJ5V0A | 1 | VD4 | SMAJ12CA-13-F | ON Semiconductor | SMBJ5V0A | Digi-Key | SMBJ5V0ACT-ND | TVS DIODE 5V 9.2V DO214AA | NF(VD4)
172 | IRLML6244TRPBF | 1 | VT1 | SOT23-3 | Infineon Technologies | IRLML6244TRPBF | Digi-Key | IRLML6244TRPBFTR-ND | N-Channel 20V 6.3A (Ta) 1.3W (Ta) Surface Mount Micro3™/SOT-23
173 | DMG1012T | 6 | VT2, VT3, VT4, VT5, VT6, VT7 | SOT523 | Diodes Incorporated | DMG1012TQ-7 | Digi-Key | DMG1012TQ-7DICT-ND | N-Channel 20V 630mA (Ta) 280mW (Ta) Surface Mount SOT-523
174 | CSD17527Q5A | 1 | VT8 | CSD17527Q5A_NMOS_8-VSONP | Texas Instruments | CSD17527Q5A | Digi-Key | 296-29021-1-ND | N-Channel 30V 65A (Tc) 3W (Ta) Surface Mount 8-VSONP (5x6)
175 | SI4848DY | 1 | VT9 | SI4848DY_NMOS_SO8 | Vishay Siliconix | SI4848DY-T1-E3 | Digi-Key | SI4848DY-T1-E3CT-ND | N-Channel 150V 2.7A (Ta) 1.5W (Ta) Surface Mount 8-SO
176 | FDC86244 | 1 | VT10 | SOT23-6 | ON Semiconductor / Fairchild | FDC86244 | Digi-Key | FDC86244DKR-ND | N-Channel 150V 2.3A (Ta) 1.6W (Ta) Surface Mount SuperSOT™-6 | NF(VT10)
177 | U7475LF 30.72MHz | 1 | XO1 | AOCJYR-10.000MHz | Rakon | U7475LF 30.72MHz | Rakon | U7475LF | ROM9070SA 30.72MHz MERC+ 9x7 HOT RC2.5 3.3V PULL
178 | E6245LF 30.72 MHz | 1 | XO2 | RAKON_RPT7050A | Rakon | E6245LF | Rakon | E6245LF | TCXO 30.72MHz, E6245LF | NF(XO2)
179 | E5280LF 30.72MHz | 1 | XO3 | RAKON_TXCO | Rakon | E5280LF | Rakon | E5280LF | TCXO 30.72MHz, E5280LF | NF(XO3)
180 | RTX5032A, 40.00MHz | 1 | XO4 | RAKON_RTX5032A | Rakon | RTX5032A | RAKON | RTX5032A | RTX5032A 40MHz, High performance TCXO, With VC, Filter Enabled, 10-pin 5mm x 3.2 mm x 1.65 mm package | NF(XO4)
181 | 25MHz | 1 | XT1 | CRYSTAL_4-LCC | ABRACON | ABM8-25.000MHZ-B2-T | Newark | 13J1767 | 25MHz ±20ppm Crystal 18pF 50 Ohm -20°C ~ 70°C Surface Mount 4-SMD, No Lead (DFN, LCC)
182 | 30MHz | 1 | XT2 | CRYSTAL_4-LCC | AVX Corp/Kyocera Corp | CX3225SB30000D0FPLCC | Digi-Key | 1253-1368-1-ND | 30MHz ±10ppm Crystal 8pF 50 Ohm -40°C ~ 85°C Surface Mount 4-SMD, No Lead (DFN, LCC)
 |  |  |  |  |  |  |  |  |  | Total NF element number: 115
 |  |  |  |  |  |  |  |  |  | All NF elements in one row:
 |  |  |  |  |  |  |  |  |  | NF(C135 C169 C179 C218 C220 C221 C222 C223 C255 C258 C272 C284 C7 C8 C18 C19 C24 C32 C256 C257 C312 C313 C224 C241 C242 C259 C307 ESD1 ESD2 ESD3 ESD4 FR50 IC2 IC16 IC5 IC7 IC21 IC25 IC30 IC37 IC41 J20 J3 J6 J11 J12 JMP2 MN4 MN5 MN22 MN6 MN18 MN26 MN8 MN12 R22 R33 R34 R47 R49 R52 R53 R55 R57 R59 R63 R71 R92 R96 R97 R114 R121 R122 R126 R128 R129 R132 R143 R148 R149 R170 R172 R173 R240 MN16 MN17 R27 R104 R195 R144 R146 R147 R186 R219 R194 R98 R158 R166 R168 R169 R171 R174 R101 R103 R175 R119 R235 R239 R241 R223 VD4 VT10 XO2 XO3 XO4)
 |  |  |  |  |  |  |  |  |  | *NOTE: NF(R1 R2) means that elements R1 and R2 are unpopulated (NF)
