EmbeddedSystemClass/LimeNET-Micro/hardware/2v1/Schematic Prints.pdf

# Clock diagram

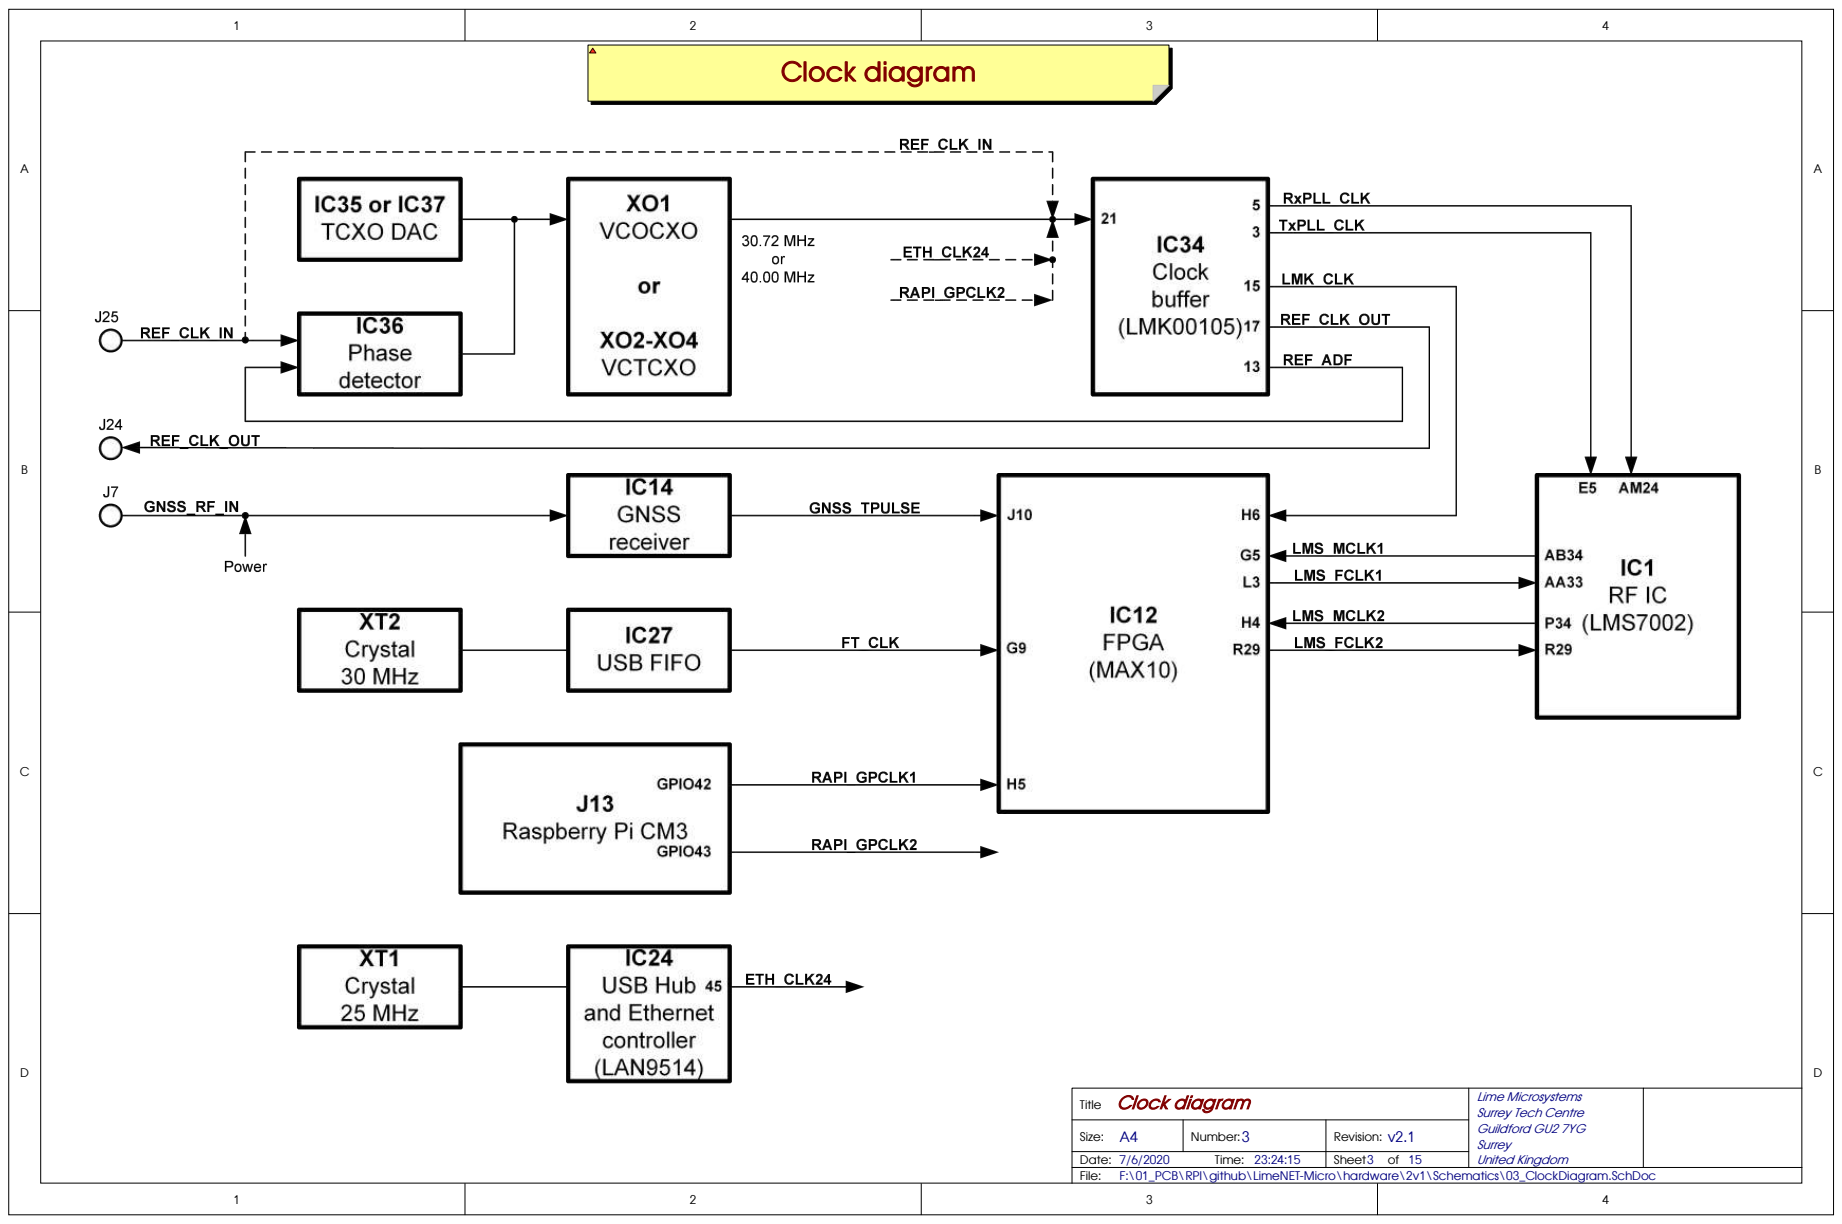
[picture p2: page 1]
United Kingdom; Clock diagram; Title; Size:; Number:; Date: File:; Revision:; Time:; Sheet

Lime Microsystems
Surrey Tech Centre
Guildford GU2 7YG
Surrey

F:\01_PCB\RPI\github\LimeNET-Micro\hardware\2v1\Schematics\03_ClockDiagram.SchDoc
