EmbeddedSystemClass/LimeNET-Micro/(list of files, drawings)

Other design files:
hardware/2v1/LimeNet-Micro_2v1-SDR.PrjPcb
hardware/2v1/Schematics/01_BlockDiagram.SchDoc
hardware/2v1/Schematics/02_PowerDiagram.SchDoc
hardware/2v1/Schematics/03_ClockDiagram.SchDoc
hardware/2v1/Schematics/04_RFDiagram.SchDoc
hardware/2v1/Schematics/05_LMS7002M_Misc.SchDoc
hardware/2v1/Schematics/06_LMS7002M_RF.SchDoc
hardware/2v1/Schematics/07_LMS7002M_Power.SchDoc
hardware/2v1/Schematics/08_FPGA.SchDoc
hardware/2v1/Schematics/09_Misc.SchDoc
hardware/2v1/Schematics/10_USB_Ethernet.SchDoc
hardware/2v1/Schematics/11_USB_FIFO.SchDoc
hardware/2v1/Schematics/12_Raspbbery CM3.SchDoc
hardware/2v1/Schematics/13_Raspberry_Misc.SchDoc
hardware/2v1/Schematics/14_Clocks.SchDoc
hardware/2v1/Schematics/15_PowerSupply.SchDoc
