EmbeddedSystemClass/LimeNET-Micro/(commit log)

2020-06-07 Remove the now ignored directory
    [LimeNET-Micro_2v1_SDR_BOMr2.xls]
2020-06-07 Create Schematic Prints.pdf
